LaithToom24/OpAmp/bare_jrnl_new_sample4.pdf

JOURNAL OF OPERATIONAL AMPLIFIER, VOL. 1, NO. 1, DECEMBER 2024 | 1

# The Design and Usage of

# a Operational Amplifier

Laith Toom and Dennis Lee

Abstract—This document details the design of an operational amplifier and using it to design a non-inverting amplifier. The design process of the amplifier will involve a DC analysis for purposes of biasing, an AC analysis for the purposes of gain, and an AC sweep for the purposes of frequency response.

Index Terms—Operational Amplifier, Circuits, Feedback, Frequency Response

I. INTRODUCTION
T
HE Operational Amplifier, otherwise referred to as an Op-Amp, operates on a differential input with an “open-loop” gain of typically at or exceeding 60 dB, input resistance of typically at or exceeding 10 MΩ, and output resistance typically at or exceeding 100 Ω. As such, the current that enters the Op-Amp is typically in the range of µ A. As such, the ideal Op-Amp is considered to have infinite open-loop gain, infinite input resistance, and zero output resistance. Given this description, an Op-Amp may be implemented in many different ways. The Op-Amp considered here will consist of three stages using BJT transistors: the Q2N3904 and the Q2N3906.

A1

V2

V1

A2 | A3 | Vo

Fig. 1. Multi-Stage Amplifier Representation

Fig. 2 shows the implementation of the Op-Amp without frequency compensation.
Ideally, the open-loop gain of the Op-Amp is given by the product of the stage gains, however, each stage will have an input and output resistance. Thus, the product of all of the gains will also be multipled by ratios derived from voltage division.

A = A1A2A3 ·

Zi2
Zo1 + Zi2

·

Zi3
Zo2 + Zi3

·

ZL
Zo3 + ZL
(1)

We can call the product of these ratios the “transmission” of the Op-Amp and denote it as σ, where the transmission of each stage will be denoted as σ1, σ2, and σ3 respectively.

σ = σ1σ2σ3 =

Zi2
Zo1 + Zi2

·

Zi3
Zo2 + Zi3

·

ZL
Zo3 + ZL

(2)

This paper was produced by the IEEE Publication Technology Group. They are in Piscataway, NJ.
Manuscript received April 19, 2021; revised August 16, 2021.

Ideally, we don’t want to lose any output, thus, we want each ratio to be one and this σ to be ideally one. Practically, σ should be close to one if each amplifier stage is designed well. Before the gain of each stage is calculated, we must first consider the biasing of the transistors within the Op-Amp.

II. THE RESISTANCES AND STAGE GAINS OF THE OP-AMP

A. Finding the Resistor Values
1) Current Mirror Load and Finding Resistor R1: The first stage of the Op-Amp, which we will denote S1, will receive the inputs V2 and V1. It will also be supplied directly with a current source; where this current source is constructed using a current mirror.
Q1 | Q2
VCC | VCC

R1

I

VEE | VEE

Load

I

Fig. 3. The Current Mirror Load

With the short from base to collector for Q1, the collector voltage of Q1 is now ideally the base voltage of Q1. Since the bases of Q1 and Q2 are shorted together, the base voltages of Q1 and Q2 are made ideally equivalent. Since the emitters Q1 and Q2 are both wired to VCC, they also have equal emitter voltages. Thus, the base to emitter voltage for Q1 and Q2 are equal. As a result, the current through Q1 will be ideally the same as the current through Q2, and so the current is “mirrored”. With a nodal analysis, we see that I depends on the potential difference across R1, and with the short from collector to base, we see that this potential difference is VCC− (VEE + VBE), thus we have an equation for I.

I =

VCC − VEE − VBE
R1

(3)

I will be the current needed to bias the amplifier, and as such, we can derive an equation for R1 as a function of I using equation 3.

0000–0000/00$00.00 © 2021 IEEE

JOURNAL OF OPERATIONAL AMPLIFIER, VOL. 1, NO. 1, DECEMBER 2024 | 2

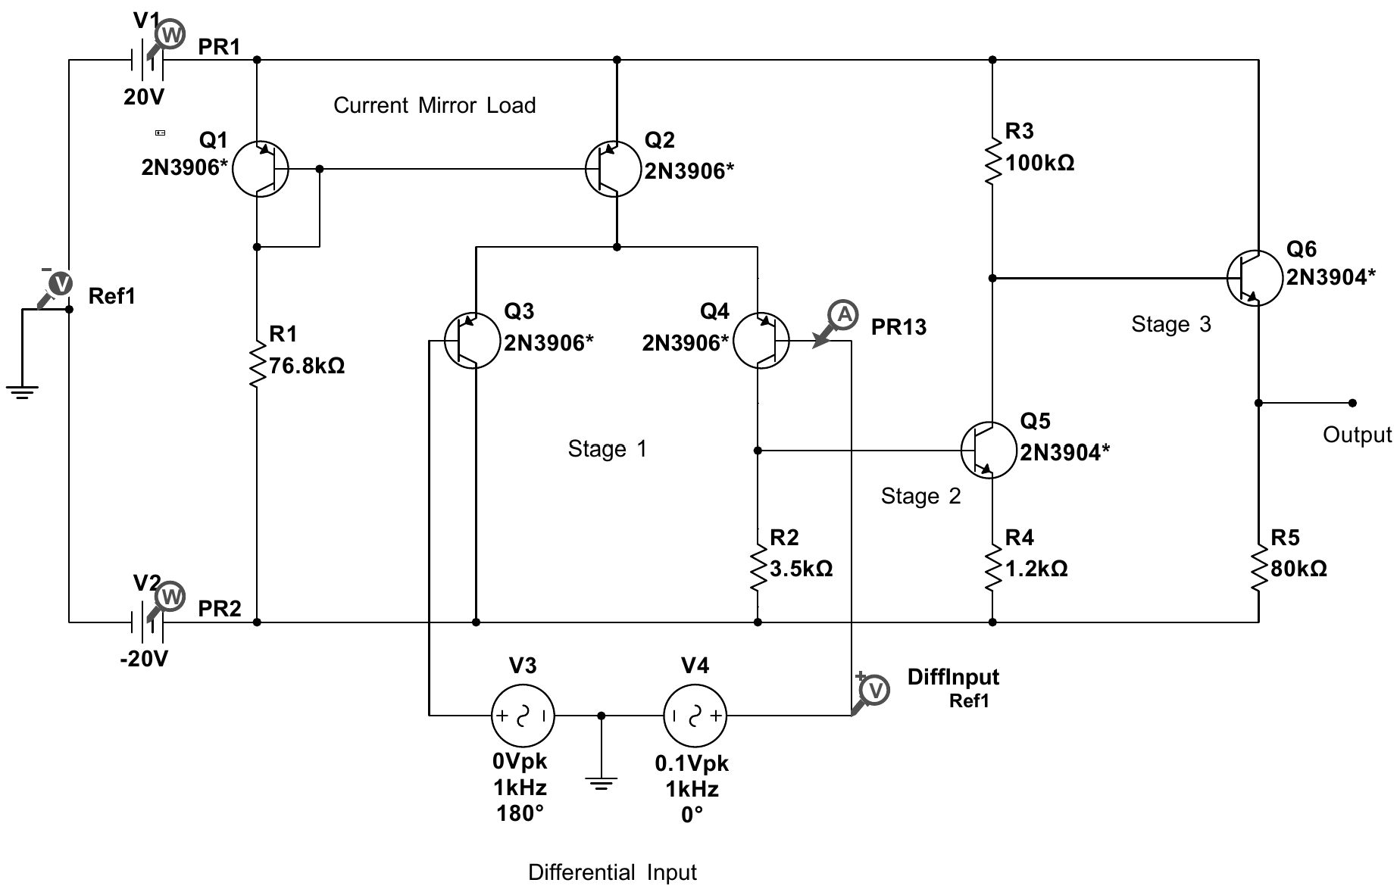
[picture p1: figure]

Fig. 2. Op-Amp Schematic Without Frequency Compensation

R1 =

VCC − VEE − VBE
I

(4)

Thus, R1 will change the biasing of the Op-Amp, but it will not directly affect the gain of the circuit. This will not be the case for the other resistors.
2) The Differential Stage and the First Stage Gain A1: The first stage of the Op-Amp is a differential bipolar amplifier; in which PNP transistors are used and the output is single-sided.
Q3 | Q4

VEE

I
2

R2

VEE

Vo

Load

I
2

VCC

I

V1 | V2

Fig. 4. The Differential Amplifier

Since the output of this differential amplifier is fed into another amplifier (the second stage of the Op-Amp), there will be some finite load at the output. The impedance of this load will then be the input impedance of the second stage, Zi2 .
The small signal equivalent of the differential amplifier can be used to determine the gain A1, but due to the single-sided output, only the half-circuit is needed. However, note that the input is differential, thus the input of the amplifier will be half of the actual input; in which the DC offset goes to AC ground.

ie

R2

vo

Zi2

re4

βib = ic

ic
β v2 =

vi
2

Fig. 5. The Differential Amplifier Small Signal Equivalent

JOURNAL OF OPERATIONAL AMPLIFIER, VOL. 1, NO. 1, DECEMBER 2024 | 3

From the small signal half circuit, nodal analysis suggests

ie = −

v2
re4

=⇒ ie = −

1
2

gm4

vi | (5)

as well as

ic =

vo
R2 ∥ Zi2

(6)

Using the current relationship between ie and ic for a bipolar junction transistor, we also find

ic =

β
β + 1

ie =⇒

vo
R2 ∥ Zi2

= −

β
2 (β + 1) gm4

vi (7)

From equation (7), the gain can be derived as so.

vo
vi

= A1 = −

β
2 (β + 1) gm4

(R2 ∥ Zi2

) | (8)

However, it’s not yet clear what resistor values A1 depends on until an expression for Zi2
is found. This impedance will be derived after all of the stage gains are found.
3) The Common Emitter Amplifier and the Second Stage Gain A2: The second stage of the Op-Amp is a common emitter amplifier; in which a NPN transistor is used.

Q5

R4

VEE

R3

Vcc

Load

Vo

Vi

Fig. 6. The Common Emitter Amplifier

Similar to the first stage, the output of the common emitter amplifier will be fed into the third stage, and the impedance of the load will then be the input impedance of the third stage, Zi3
. The gain can be determined by using the small signal equivalent model.

R4

ie

R3 ∥ Zi3

vi

ic
β
re5

gm5 vbe = ic

vo

Fig. 7. The Common Emitter Amplifier Small Signal Equivalent

From the small signal equivalent model, ie and ie can be expressed using Ohm’s Law.

ic = −

vo
R3 ∥ Zi3

(9)

ie =

vi
re5 + R4

(10)

Thus, the gain A2 can be derived.

vo
vi

= A2 = −

R3 ∥ Zi3
re5 + R4

(11)

As with the first stage gain, Zi3 must be derived before determing which resistors the second stage gain will depend on.
4) The Common Collector Amplifier and the Third Stage Gain A3: The third stage of the Op-Amp is a common collector amplifier; which is also known as a emitter-follower, and is implemented using a NPN transistor.

Q6

R5

VEE

Vcc

Load

Vo

Vi

Fig. 8. The Emitter-Follower

While the output of this amplifier will not be fed into another stage, it will be connected to some load, such as a feedback system. That said, this is simply a buffer amplifier; in which there is no amplification nor, ideally speaking, attenuation. By using the small signal model, this can be proven.

JOURNAL OF OPERATIONAL AMPLIFIER, VOL. 1, NO. 1, DECEMBER 2024 | 4

R5 ∥ ZL

ie

vi

ic
β
re6

gm6 vbe = ic

vo

Fig. 9. The Emitter-Follower Small Signal Equivalent

From the small signal model, vo can be expressed using voltage division, in which re6

and R5 ∥ ZL form the voltage divider.
vo =

R5 ∥ ZL
re6 + R5 ∥ ZL
vi | (12)

Thus, the gain of the third stage can be derived. vo
vi

= A3 =

R5 ∥ ZL
re6 + R5 ∥ ZL

(13)

Note that for ZL = ∞, the equation is simplified. vo
vi

= A3 =

R5
re6 + R5

(14)

Practically, re6

is usually magnitudes smaller than R5 ∥ ZL; in which both ZL and R5 are usually magnitudes above re6 .
Thus, there are two limit conditions we can consider for A3 to verify that the third stage is indeed a buffer amp.

lim re6→0

R5 ∥ ZL
re6 + R5 ∥ ZL

=

R5 ∥ ZL
R5 ∥ ZL
= 1 | (15)

lim
R5∥ZL→∞

R5 ∥ ZL
re6 + R5 ∥ ZL

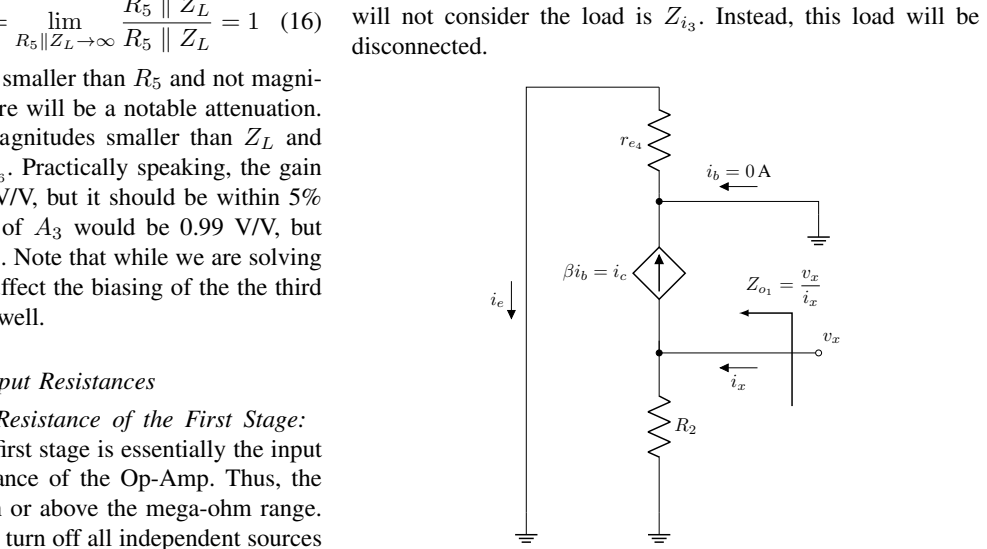
[picture p2: figure]
. Practically speaking, the gain; will not consider the load is Zi3; . Instead, this load will be; disconnected.; βib = ic

= lim
R5∥ZL→∞

R5 ∥ ZL
R5 ∥ ZL

However, if ZL is magnitudes smaller than R5 and not magnitudes larger than re6
, then there will be a notable attenuation. The same applies if R5 is magnitudes smaller than ZL and not magnitudes larger than re6
of this stage will never be 1 V/V, but it should be within 5% of 1 V/V. A fair assumption of A3 would be 0.99 V/V, but this all depends on R5 and ZL. Note that while we are solving for stage gains here, R5 will affect the biasing of the the third stage, so it will affect re6
as well.
B. Finding the Input and Output Resistances
1) The Input and Output Resistance of the First Stage: This resistance, seeing as the first stage is essentially the input stage, is also the input resistance of the Op-Amp. Thus, the resistance is expected to be in or above the mega-ohm range. In order to find this resistance, turn off all independent sources and apply a test source where the resistance is met. For the first stage, recall Fig. 5 and replace the differential input with test source vx.

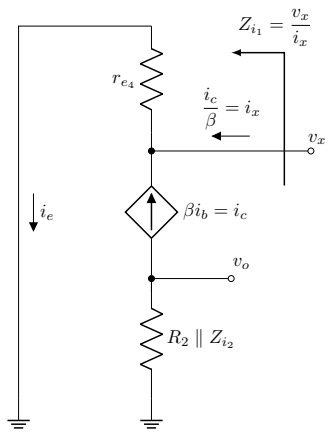
[picture p3: figure]
βib = ic

Fig. 10. Testing the Differential Amplifier for Input Resistance

Either by reflecting the emitter resistance re4
to the base
or by using nodal analysis with the current relation between ie and ib, the input resistance is easily derived. We will use nodal analysis to find Zi1

ie =

vx
re4

(17)

ix = ib | (18)
ie = (1 + β)ib | (19)

=⇒

vx
re4
= (1 + β)ix | (20)

=⇒

vx
ix

= Zi1 = (1 + β)re4
(21)

Starting with the same small signal model, we can ground the input terminal and place a test source at the output terminal to find the output impedance of the first stage, Zo1 .
However, since we are inputting a source at the output, we

Fig. 11. Testing the Differential Amplifier for Output Resistance

Since the input is grounded, this means there is no voltage applied at the base of the transistor. Thus, there is no current

JOURNAL OF OPERATIONAL AMPLIFIER, VOL. 1, NO. 1, DECEMBER 2024 | 5

flowing into the terminal, making ie = ic = 0 A as they
directly depend on ib. As such, the dependent current source
supplies no current, and so the current ix is not split.

ix =

vx
R2

(22)

=⇒

vx
ix
= Zo1 = R2 | (23)
2) The Input and Output Resistance of the Second Stage: The same process applied to the first stage is used here, however, now recall Fig. 7 as the circuit to analyze.

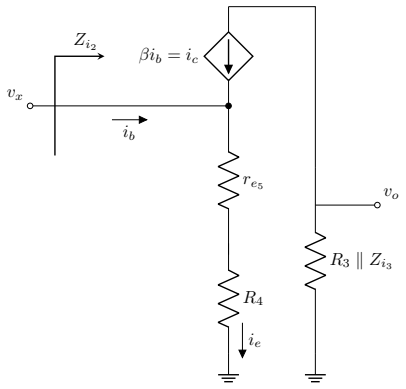
[picture p4: figure]
βib = ic

Fig. 12. Testing the Common Emitter Amplifier for Input Resistance

Using nodal analysis, finding the input impedance is a simple process.

ib = ix | (24)
ie = (1 + β)ib | (25)

ie =

vx re5 + R4 | (26)

=⇒ (1 + β)ix =

vx re5 + R4 | (27)

=⇒

vx
ix
= Zi2 = (β + 1)(re5 + R4) | (28)

Looking at Fig. 12, if the input terminal is grounded and vx is placed at the output terminal, it’s clear to see that the output resistance is simply R3.

Zo2 = R3 | (29)
3) The Input and Output Resistance of the Third Stage: Recall the small signal model of the third stage (Fig. 9). The same process used for the previous two stages can be used here.

R5 ∥ ZL

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
Fig. 13. Testing the Emitter-Follower for Input and Output Impedance

From this circuit, the input and output impedances are easy to see. For the input resistance, re6

and R5 ∥ ZL are in series, thus they can be reflected to the base as a sum.

Zi3 = (β + 1)(re6 + R5 ∥ ZL) | (30)

For the output resistance, re6

and R5 are in parallel.

Zo3 = re6

∥ R5 | (31)
C. The Resistor Dependent Gain Equation
With all of the resistances and gains found, it’s now possible to write an equation for A.

A1 = −

β(R2 ∥ (β + 1)(re5 + R4)) 2(β + 1)re4 | (32)

A2 = −

R3 ∥ (β + 1)(re6 + R5 ∥ ZL) re5 + R4 | (33)

σ1 =

(β + 1)(re5 + R4) R2 + (β + 1)(re5 + R4) | (34)

σ2 =

(β + 1)(re6 + R5 ∥ ZL) R3 + (β + 1)(re6 + R5 ∥ ZL) | (35)

σ3 =

ZL (re6 ∥ R5) + ZL | (36)

A = A1A2A3 · σ1σ2σ3 = A

′
- σ | (37)

See Eq. (38) for the full equation for A′ and Eq. 39 for the
full equation of σ. Since σ ≈ 1, A′
is the primary concern
for determing A. Since A depends on the value of the emitter resistances, recall that the emitter resistances depend on the collector current flowing through the transistors, and those currents depend on the resistor values chosen for the Op-Amp. Thus, the resistor values must be chosen with consideration for gain A and proper biasing.

III. THE DC BIASING
OF THE OP-AMP
Recall that the emitter resistance of a BJT is given by the ratio of the thermal voltage VT to the collector current Ic.

re =

VT Ic | (40)

Looking back to the current mirror (Fig. 3) and Eq. (4), this is where the main part of the biasing comes into play. With the

JOURNAL OF OPERATIONAL AMPLIFIER, VOL. 1, NO. 1, DECEMBER 2024 | 6

A

′ =

β(R2 ∥ (β + 1)(re5 + R4))
2(β + 1)re4

·

R3 ∥ (β + 1)(re6 + R5 ∥ ZL) re5 + R4

·

R5
re6 + R5

(38)

σ =

(β + 1)(re5 + R4)
R2 + (β + 1)(re5 + R4)

·

(β + 1)(re6 + R5 ∥ ZL)
R3 + (β + 1)(re6 + R5 ∥ ZL)

·

ZL
(re6

∥ R5) + ZL

(39)

equation, I can be anything. As such, we can already control re4
in regards to current.

Ic4 =

β
β + 1

Ie4
(41)

Ie4 =

I
2

(42)

re4 =

VT
Ic4

=

2 (β + 1) VT
βI | (43)

In regards to re5

, the base current of Q5 will be given by current division.

Ib5 =

R2
R2 + Zi2

Ic4
(44)

=⇒ Ib5 =

R2
R2 + Zi2
β

β + 1
I
2

(45)

=⇒ Ic5 =

R2
R2 + Zi2
β

2
β + 1
I
2

(46)

Ic5 =

VT
re5

(47)

=⇒

(β + 1)re5 + (β + 1)R4 + R2 re5

=

R2
VT
β

2
2(β + 1)
I (48)

=⇒ re5 =

R2 + (β + 1)R4
β

2
IR2
2(β + 1)VT

− (β + 1)

(49)

Then for re6

, the base current of Q6 will be given by another current division; in which the collector current of Q5 will be divided between R3 and Zi3

Ib6 =

R3
R3 + Zi3

Ic5
(50)

=⇒ Ib6 =

R3
R3 + Zi3

·

R2
R2 + Zi2
β

2
β + 1
I
2

(51)

=⇒ Ic6 =

R3
R3 + Zi3

·

R2
R2 + Zi2
β

3
β + 1
I
2

(52)

Ic6 =

VT
re6

(53)

=⇒ re6 =

R3 + (β + 1)(R5 ∥ ZL)
β

3
IR3
2(β + 1)VT
R2
R2 + Zi2
− (β + 1)

(54)

However, despite deriving these equations, tweaking the resistor values based off of these equations will not always match the measured gain. This is because the equations always assume the transistors are always operating in active mode, and if a change in a resistor value pushes a transistor into saturation, these equations are no longer applicable.

IV. EXPERIMENTING WITH RESISTOR VALUES
While calculating the resistor values would be both difficult and likely inefficient, the equation derived for the open-loop gain without considering transmission loss, see Eq. (38), provides some incentive on how to tweak the resistor values.
A. Current Mirror Load
For the current mirror, R1 set to 76.8 kΩ was found to properly bias the amplifier; in which the current supplied using this resistance can be calculated using Eq. (3), and when calculated, provides I ≈ 0.512 mA.
B. First Stage
For the first stage, since R2 is in parallel with Zi2
, in-creasing R2 will not increase the gain. Instead, the parallel combination will approach the lesser resistance. So in order to increase the gain of the first stage, setting R2 to 3.5 kΩ and tweaking R4 would be a decent method.
C. Second Stage
Note that the second stage gain is inversely proportional to R4, so while setting R4 to a very high value would seem like a good idea as to increase the first stage gain, we instead want to limit R4. Since R4 is scaled by β+1 for the previous stage, this means R4 will already be far larger from the perspective of the first stage than for the second stage. In this case, setting R4 to 1.2 kΩ provides satisfactory results.
As for R3, we have the same situation as with the first stage. Thus, we should pick a value for R3 and then tweak R5. As such, setting R3 to 100 kΩ provides good results.
D. Third Stage
With the third stage, setting R5 to a very large value, such as in the megaohms, would work unlike the first stage since, as Eq. (13) suggests, R5 ≫ re6 provides gain close to 0 dB, which is ideal. However, this is only the case when the Op-Amp is not supplying a finite load. When a finite load ZL is attached to the output terminal of the Op-Amp, R5 will be parallel to this impedance, and as shown in Eq. (13), this effects the gain of the buffer stage. The effect can be shown by limits in which ZL is kept constant while R5 is taken to infinity.

lim
R5→∞

R5 ∥ ZL
re6 + R5 ∥ ZL

=

ZL
re6 + ZL

(55)

With this simplification, it is clear to see that R5 is eventually disregarded as it is increased. This behavior is non-ideal because this means that the gain now depends largely on

JOURNAL OF OPERATIONAL AMPLIFIER, VOL. 1, NO. 1, DECEMBER 2024 | 7

ZL. Specifically, the measure of how large ZL is to re6
. For
example, if R5 was chosen to be 1000re6
, then the buffer gain
without a load would be 1000
1001 V/V (see Eq. (14)). However, if we connect a load of ZL = 100re6
, then firstly, the parallel combination can be computed. From there, we can compute the gain.

ZL ∥ R5 = 100re6

∥ 1000re6
(56)

=

100re6

- 1000re6
100re6 + 1000re6

(57)

=

10⁵
1100
- re6
(58)

=⇒ A3 =

10⁵
1100 re6
re6 +

10⁵
1100 re6

(59)

=

10⁵

1100

10⁵+1100

1100 | | (60)

=

10⁵
10⁵ + 1100

=

1000
1011
V/V | (61)

=⇒ ∆A3 =

1000
1001

−

1000
1011
≈ 10⁻² V/V | (62)
≈ 0.0863 dB | (63)

While R5 and ZL only differed by a factor of ten, it’s clear to see that this loss in gain can be increased if this factor increases, and that would be very likely if R5 is in the range of megaohms. Thus, R5 was chosen to be 80 kΩ.

V. OP-AMP SPECIFICATIONS WITH REGARDS TO RESISTOR VALUES
A. Power Dissipation

With the resistor values chosen, the power dissipated by the Op-Amp is easily calculated. For currents that flow to VEE, the sum of those currents multiplied by VEE provides the power dissipated as a result of those currents.

PEE = |VEE|

X

N

i=1

Ii | (64)

Then for currents flowing to VCC, replace VEE with VCC.

PCC = VCCX

M

i=1

Ii | (65)

Thus, the total power dissipation is given by the following equation.

Pnet = VCCX

M

i=1

Ii + |VEE|

X

N

i=1

Ii | (66)

With this equation, the total power dissipation was found to be 58 mW. The simulation reported a total power dissipation of 58.4 mW.

B. Input Bias Current
Due to the nature of BJTs, there is some current introduced by the input terminal into our Op-Amp design. As such, this current is called the input current or input bias current. This current was found to be approximately 1 microamp.
C. Measured Open-Loop Gain
When performing an AC Sweep, the open-loop gain was found to be 61.84 dB. When applying equations (2), (38), (43), (49), and (54); the open-loop gain was calculated to be 62.6109 dB. Thus, the difference relative to the calculation was approximately 1.2%.

E% = Acalculated − Ameasured

Acalculated

≈ 1.23% | (67)

The value of σ was about 0.987.

D. Open-Loop Bandwidth and Dominant Pole
Bode plots for the open-loop gain and phase were created in Matlab. See Fig. 14 for open-loop gain and 15 for open-loop phase. The plots suggests that a pole exists at 258.73 kHz, thus a bandwidth of 0 Hz to 258.73 kHz.
E. Common-Mode Input Range
For the common-mode input range, the circuit analysis is only concerned with the first stage of the Op-Amp since it acts as the input stage. As such, referring back to Fig. 4, VCMmin and

VCMmax
can be calculated by assuming the saturation conditions VCB = 0.4 V, VCE = 0.3 V, and VEB = 0.7 V.
VCMmin = IcR2 + VCB − VCC | (68)

≈

I
2
R2 + VCE − VCC = −18.7045 V | (69)
VCMmax = VCC − VCE − VEB = 19 V | (70)

VI. DC TRANSFER CHARACTERISTICS
Now with the Op-Amp designed, we can now perform various tests on the Op-Amp. For the DC transfer characteristics of the Op-Amp, we will consider that the inverting terminal is grounded, the non-inverting terminal is connected to a DC supply, and there is a 10 kΩ load.

−

+

A

Vi

RL = 10 kΩ

We will sweep Vi from -100 mV to 100 mV in steps of 0.1 mV, and the slope of the linear aspect of the DC Transfer characteristics will yield the gain. This gain be compared to the calculation of A′σ. The data collected from the DC sweep was processed in Matlab (see Fig. 16).

JOURNAL OF OPERATIONAL AMPLIFIER, VOL. 1, NO. 1, DECEMBER 2024 | 8

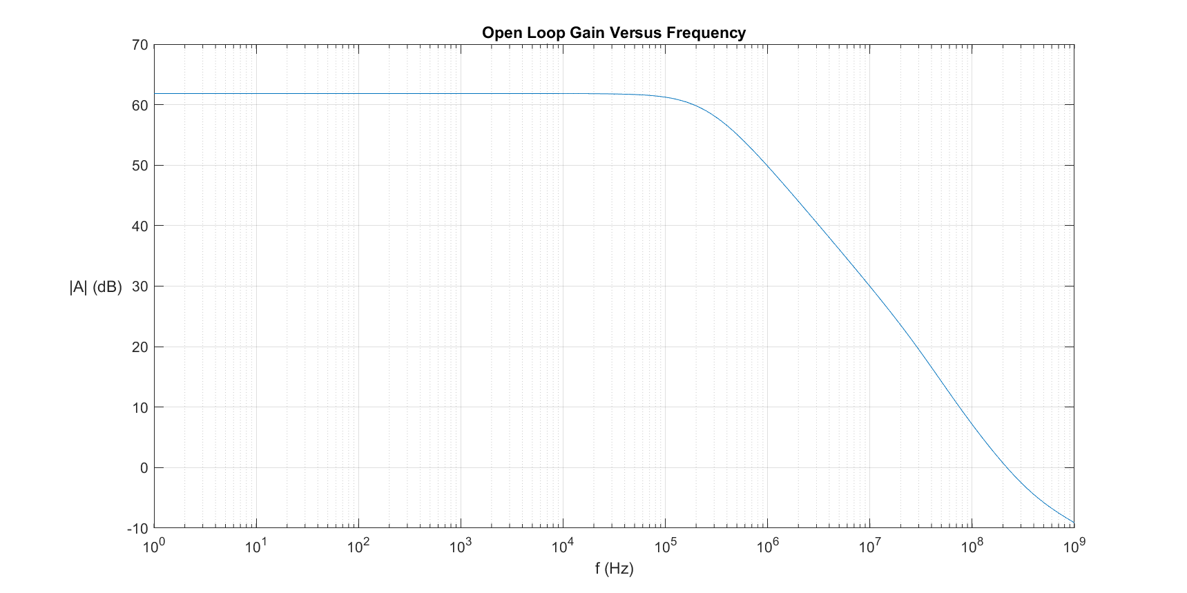
[picture p5: figure]

Fig. 14. Bode Plot of Open-Loop Gain

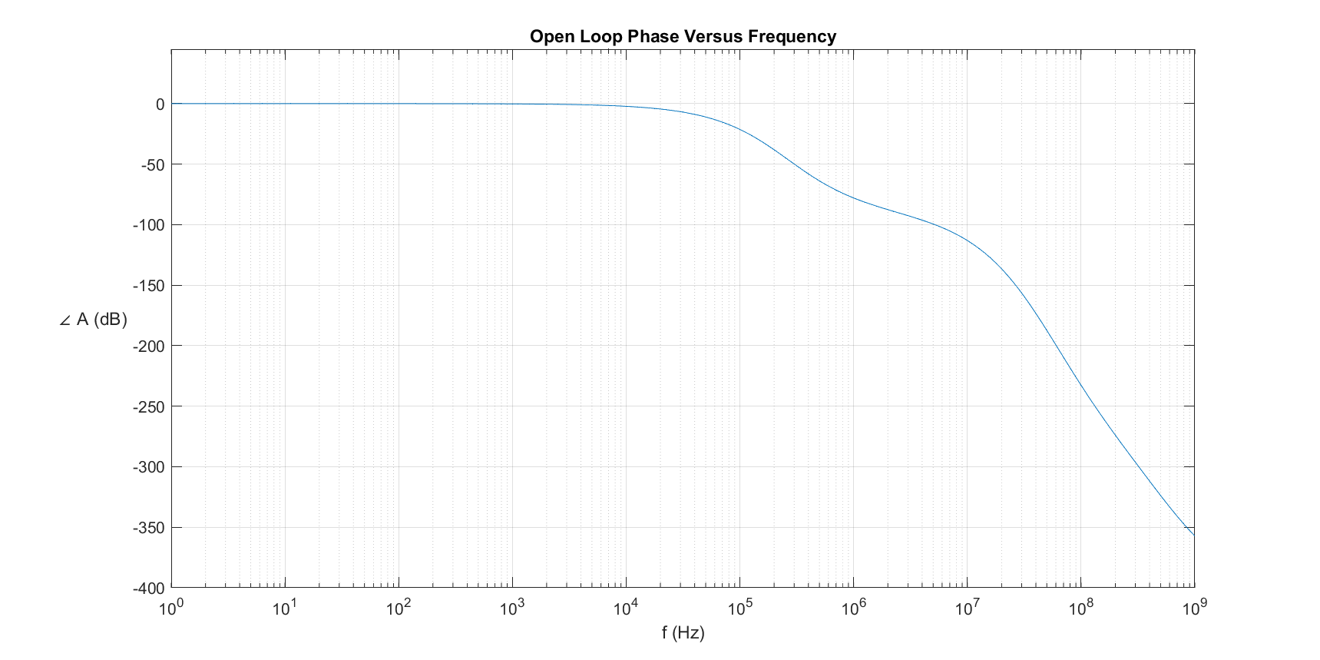
[picture p6: figure]

Fig. 15. Bode Plot of Open-Loop Phase

From the plot, the closest eyeball approximation to linear behavior between Vi and Vo is between 1 mV and 6 mV, in which the slope was calculated to be 1105.5 V/V, or in units of decibels, 60.871 dB. With the formula derived for the open-loop gain, the calculation provided 62.02 dB, thus presenting an error of approximately 2% relative to the calculation.

E% = Acalculated − Ameasured

Acalculated

≈ 1.94% | (71)

Compared to the gain with no attached load, which is equivalent to saying ZL = ∞, there is an approximate loss of 0.969 dB, and this makes sense as ZL = 10 kΩ while R5 = 80 kΩ.

VII. FREQUENCY COMPENSATION
Reviewing the bode plots (see Fig. 14 and Fig. 15), we see that at 0 dB, the phase shift is past -180◦
. As such, the
system is unstable, or rather, if we were to introduce feedback, the system would undergo positive feedback. In order to implement the various Op-Amp circuits we are familiar with,

JOURNAL OF OPERATIONAL AMPLIFIER, VOL. 1, NO. 1, DECEMBER 2024 | 9

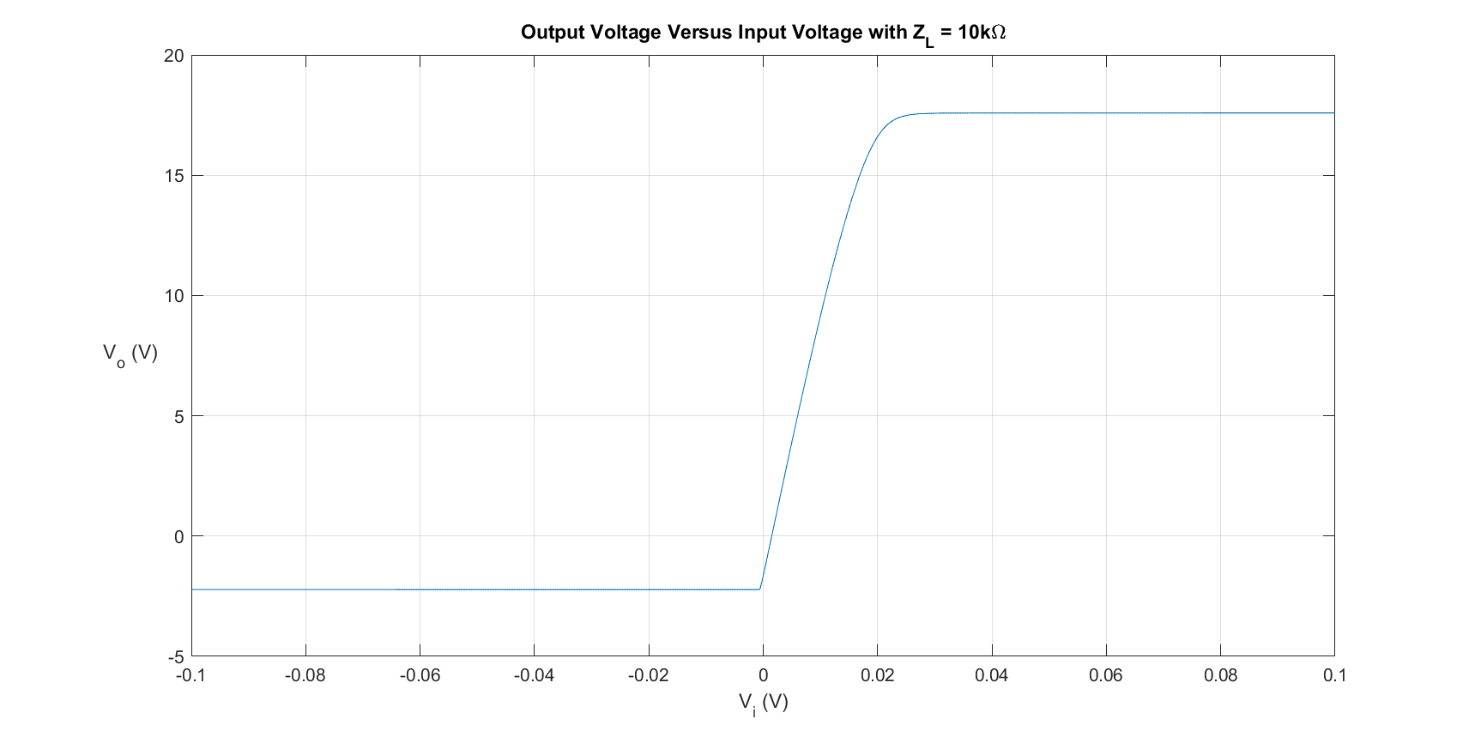
[picture p7: figure]

Fig. 16. DC Transfer Characteristics

such as a non-inverting amplifier or a weighted summer, we need to alter the design such that the phase shift is within -180◦ to 180◦ when the gain is 0 dB. While there are a few different methods of so-called frequency compensation, we will apply “Miller’s compensation”.

A. Miller’s Compensation Capacitor

After experimenting with different feedback capacitor place-ments, the best placement was found to be a 200 pF capacitor at the third stage.

Q6

R5

VEE

Vcc

Load

Vo

Vi

Cm = 200 pF

Fig. 17. The Frequency Compensated Emitter-Follower

Essentially, the capacitor will provide a pole, and due to Miller’s effect, the compensation capacitor will be amplified. Thus, a smaller capacitor can be used, such as the chosen 200 pF capacitor. However, this new pole becomes the new dominant pole, resulting in a loss of bandwidth. However, at unity gain (0 dB), we now have a phase of approximately −130◦
, thus we are now stable and have a phase margin of approximately 50◦

, which is greater than 45◦ . See Fig. 18 and
19 for this drawback.

VIII. IMPLEMENTING FEEDBACK AND BUILDING A NON-INVERTING AMPLIFIER

With the frequency-compensated Op-Amp, we can now introduce feedback.

−

Op-Amp

Resistor
Network
Vi | Vo

Fig. 20. Block Diagram for a Negative Feedback System

For a non-inverting amplifier, we expect the system to amplify the signal, but not invert it. Thus, for any input Vi ,
we expect the output to be |Af | Vi
, where Af is the gain of
the feedback system. As Fig. 20 suggests, the feedback gain Af is given by the following equation.

Af =

A
1 + A(s) · B

=

1

1
A(s) + B

(72)

JOURNAL OF OPERATIONAL AMPLIFIER, VOL. 1, NO. 1, DECEMBER 2024 | 10

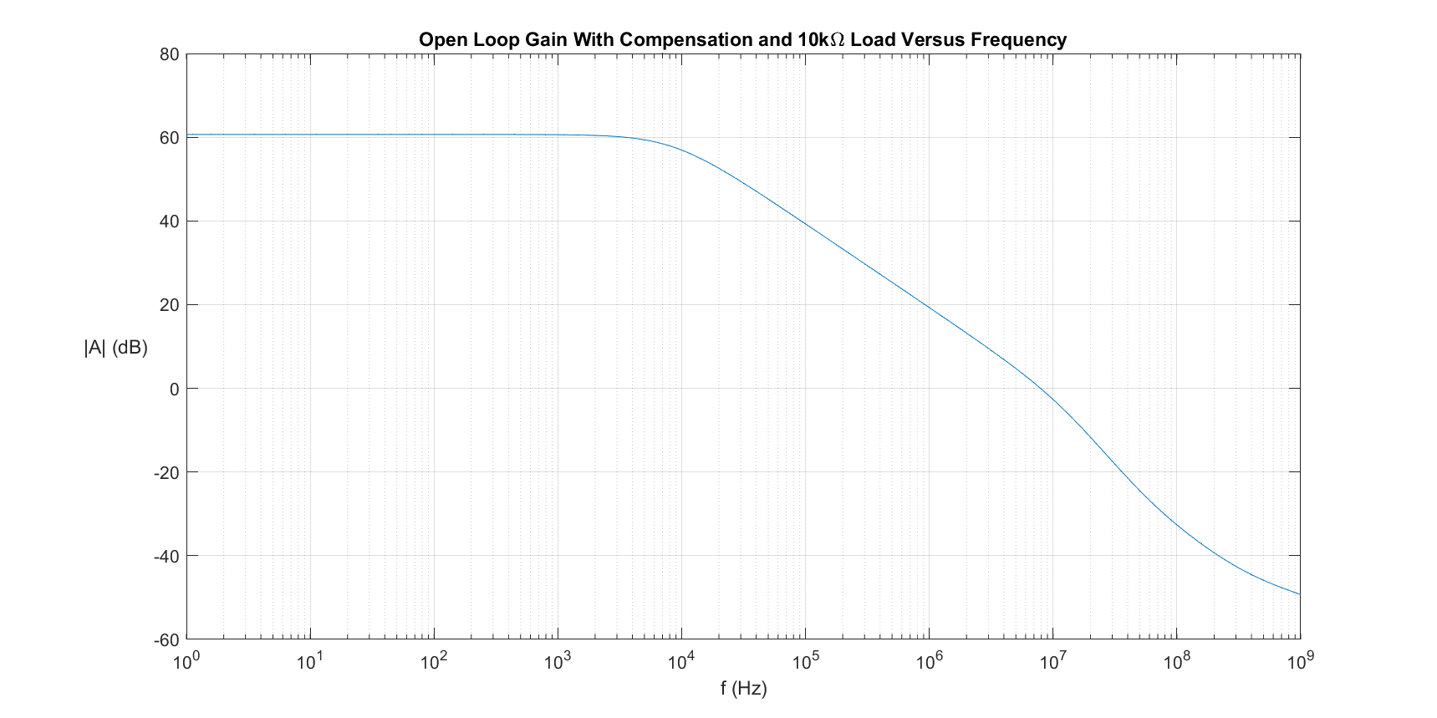
[picture p8: figure]

Fig. 18. Bode Plot of Open-Loop Gain After Frequency Compensation

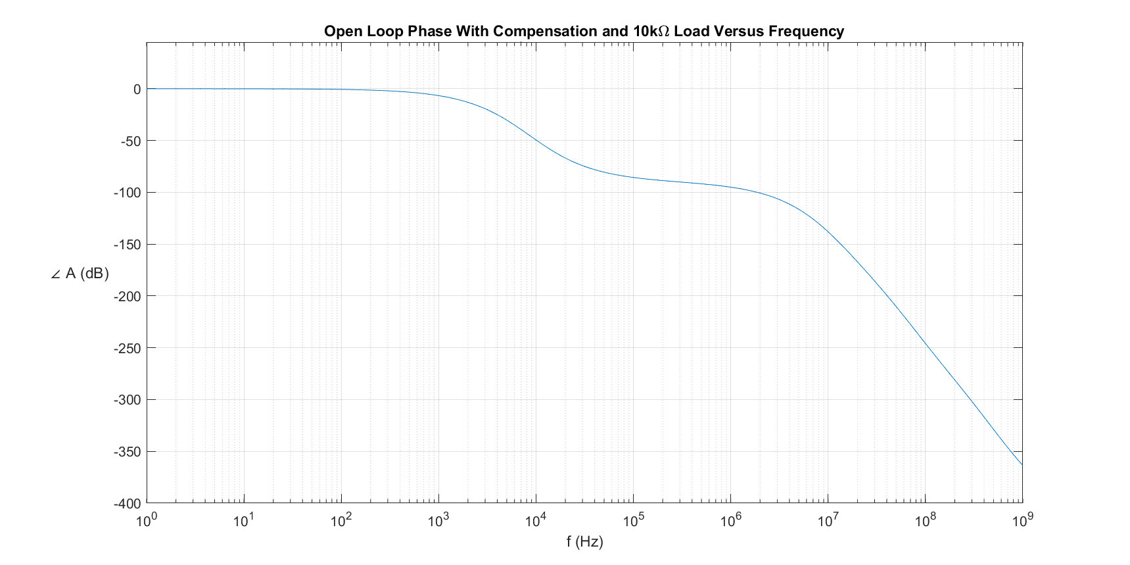
[picture p9: figure]

Fig. 19. Bode Plot of Open-Loop Phase After Frequency Compensation

Where A(s) is the open-loop gain of the Op-Amp and B is the gain from feedback: the “loop gain”. We have already designed A(s), and for a desired Af , we can solve for B.

B =

1
Af

−

1
A(s)

=

A(s) − Af
AfA(s)

(73)

While this suggests that B will or should be frequency-dependent, we can assume that A(s) is constant if s is in the bandwidth found earlier. Thus, B can be implemented as a non-frequency dependent system when we consider this bandwidth.
B =

1
Af

−

1
A

=

A − Af
AfA

(74)

A. Designing the Non-Inverting Amplifier
The goal is to design a non-inverting amplifier with Af = 20 dB= 10 V/V. Recall that A is already experimentally found

JOURNAL OF OPERATIONAL AMPLIFIER, VOL. 1, NO. 1, DECEMBER 2024 | 11

to be approximately 61.84 dB= 1235.95 V/V. As such, B can
be calculated.
Af = 10 | (75)
A ≈ 1235.95 | (76)

=⇒ B ≈

1
10

+

1
1235.95

≈ 0.10081 V/V (77)

This is the gain we expect from our resistor-network. Since the gain is less than one, we can consider using a Voltage-Divider network.

Rb

V

′
o = B · V

′
i
Ra | V
′
| i

Fig. 21. Voltage-Divider Network

As the analysis suggests, B will simply be the ratio of Rb to the sum of Ra and Rb.

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
Ra + Rb

(78)

When we implement this as feedback into your system, V

′
i =
Vo and V

′
o = B ∗ Vo. When we introduce the open-loop gain as our Op-Amp, we can use the idea that the Op-Amp sees a differential input; in which the input is the potential difference from the non-inverting terminal to the inverting terminal. As such, if we wire the output of our voltage-divider network to the inverting terminal of the Op-Amp, we essentially achieve the same functionality as the adder seen in Fig. 20; in which the adder acts as a subtracter.

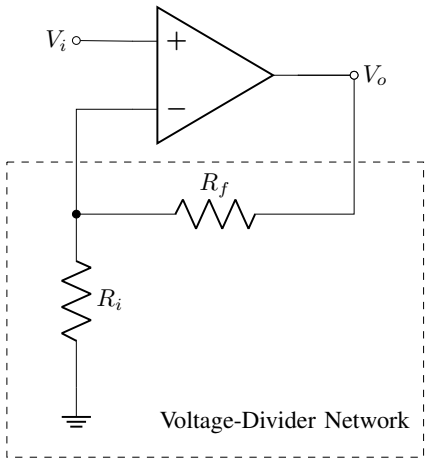
[picture p10: figure]
Voltage-Divider Network

Fig. 22. Non-Inverting Amplifier

For the amplifier, we will let Ra = Rf and Ri = Rb. Seeing as we already calculated B, we can now select values for Ra and Rb. An easy way to do this is to solve for one resistor in terms of the other given that our network is relatively simple.

Eq. (78) =⇒ BRa + BRb = Rb | (79)

=⇒ Rb =

B
1 − B
Ra | (80)

We can now select Ra and then simply calculate Rb. Alternatively, we can select Rb and then calculate Ra.

Ra =

1 − B
B
Rb | (81)

Ideally, we should not lose any of our output. However, with a circuit, the feedback and resistor-network will force some of the output current to flow through the feedback loop, thus reducing the output. In order to remedy this, Rb can be chosen to be some resistance in the kilo-ohm range, thus reducing the amount of current that flows through the feedback loop as per current division. As such, we will choose Ra to be 15 kΩ.

Ra = 15 kΩ =⇒ Rb ≈ 1681.68 Ω | (82)

However, this is not an ideal number to work with, and in practice, is inefficient due to resistor tolerance. Thus we will select 1.65 kΩ for Rb. See Fig. 27 for the schematic of the non-inverting Op-Amp.
1) Input Impedance of the Non-Inverting Amp: With the feedback added, the input impedance of the entire system has changed. Without feedback, the input impedance would just be the input impedance of the first stage Zi1
, but now, the
input impedance is Zi

Zi = Zi1

(1 + AB) ≈ 3.85 MΩ | (83)

To experimentally find the input impedance, we can apply a test source Vx to the terminal and measure the current entering the amplifier. From here, calculate the ratio of the test source voltage to input current, and this ratio should theoretically be the input impedance.

B. Results

With the non-inverting amplifier designed, we can now simulate it and verify that it works to our specifications. An AC Sweep was performed without a load attached to the output of the non-inverting amplifier. With that in mind, the bode plots of the gain and phase with feedback are provided (see Fig. 25 and 26).
When we apply a sinusoidal input vi = 2 sin(ωt) with f = 1 kHz, we observe the following. While we expect an output of approximately vo = 20 sin(ωt), we instead get some kind of distortion (see Fig. 23). This is due to the results of the DC transfer as seen in Fig. 16, in which the linear operating range is only in the millivolts. With the feedback, this range failed to include up to 2 volts as shown in Fig. 24; in which our range of inputs that produce linear outputs is only between approximately -0.4 V and 1.8 V.

JOURNAL OF OPERATIONAL AMPLIFIER, VOL. 1, NO. 1, DECEMBER 2024 | 12

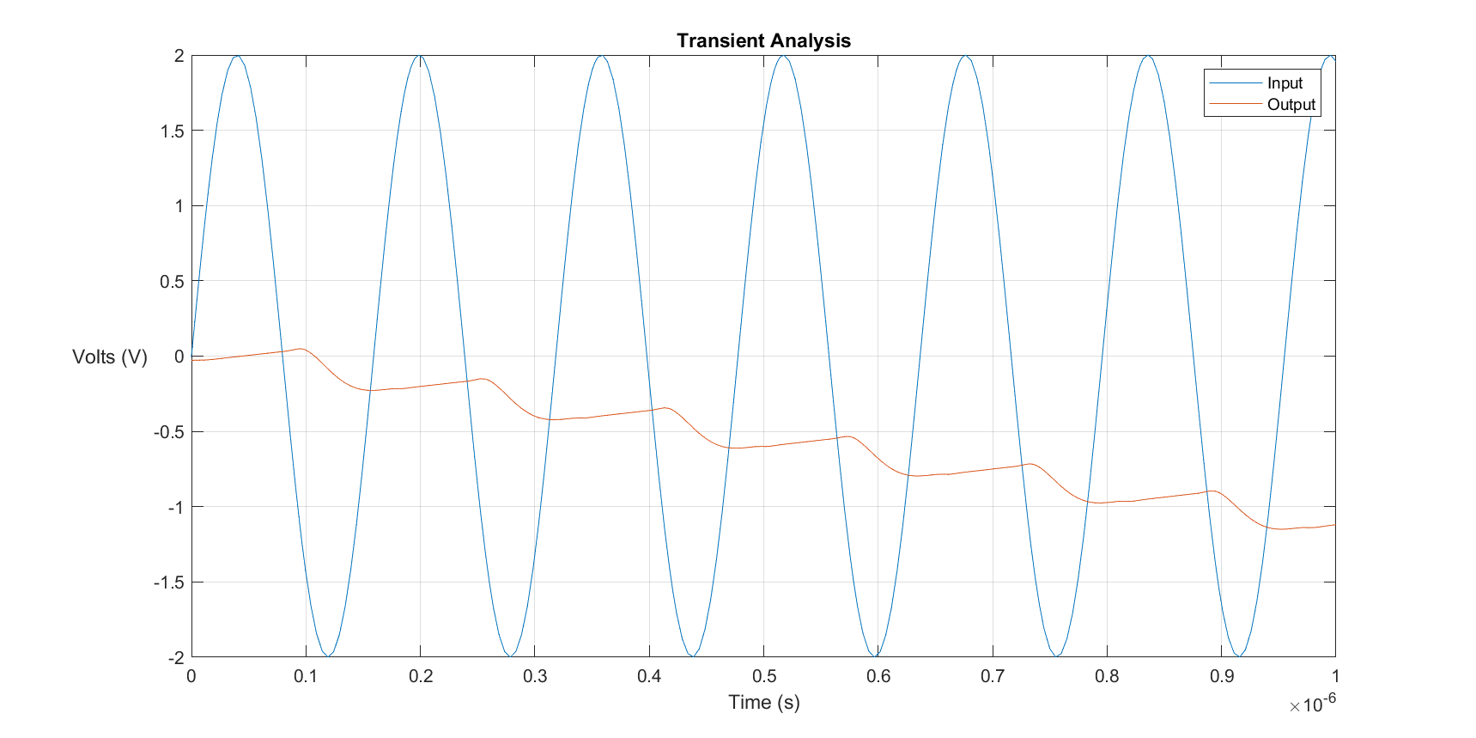
[picture p11: figure]

Fig. 23. Transient Analysis

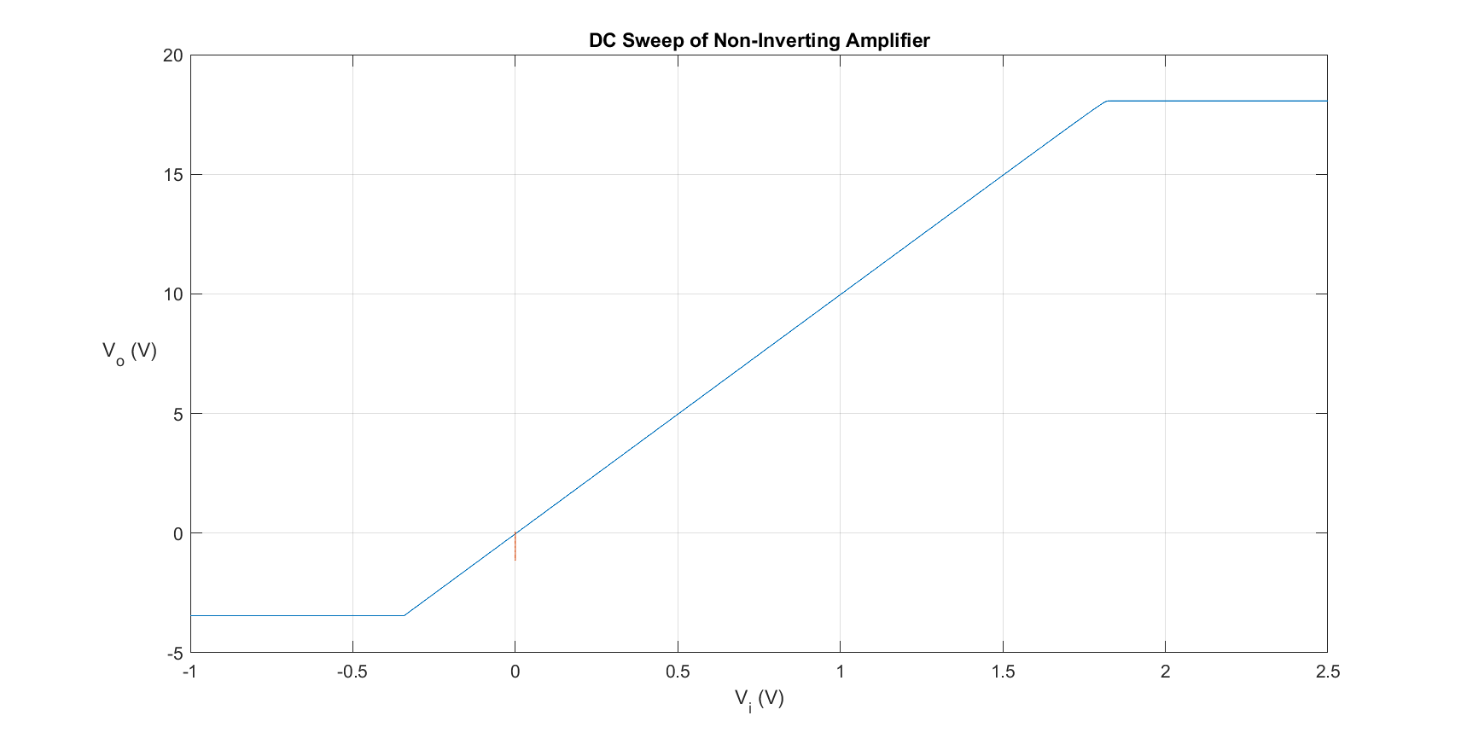
[picture p12: figure]

Fig. 24. DC Sweep for Non-Inverting Amplifier

IX. CONCLUSION

We can summarize the final design with a table of specifications (see Table I) In short, the Op-Amp is itself a complicated and sensitive device. However, when combined with feedback, it can produce powerful results. Furthermore, optimizations to the Op-Amp itself help with these feedback implementations. As a drawback, the gain of the Op-Amp is not used to amplify signals directly, but to ensure that feedback is stable. Alternative designs of this Op-Amp may involve using additional stages to further increase open-loop gain, but that comes at the cost of using more transistors as well as a higher power dissipation. As for the types of transistors used, using MOSFETs instead of BJTs would allow for the Op-Amp to have infinite input impedance and lower power dissipation. Overall, there are many different designs for an Op-Amp; in which the design process of an Op-Amp will involve a theoretical analysis followed by experimental optimizations.

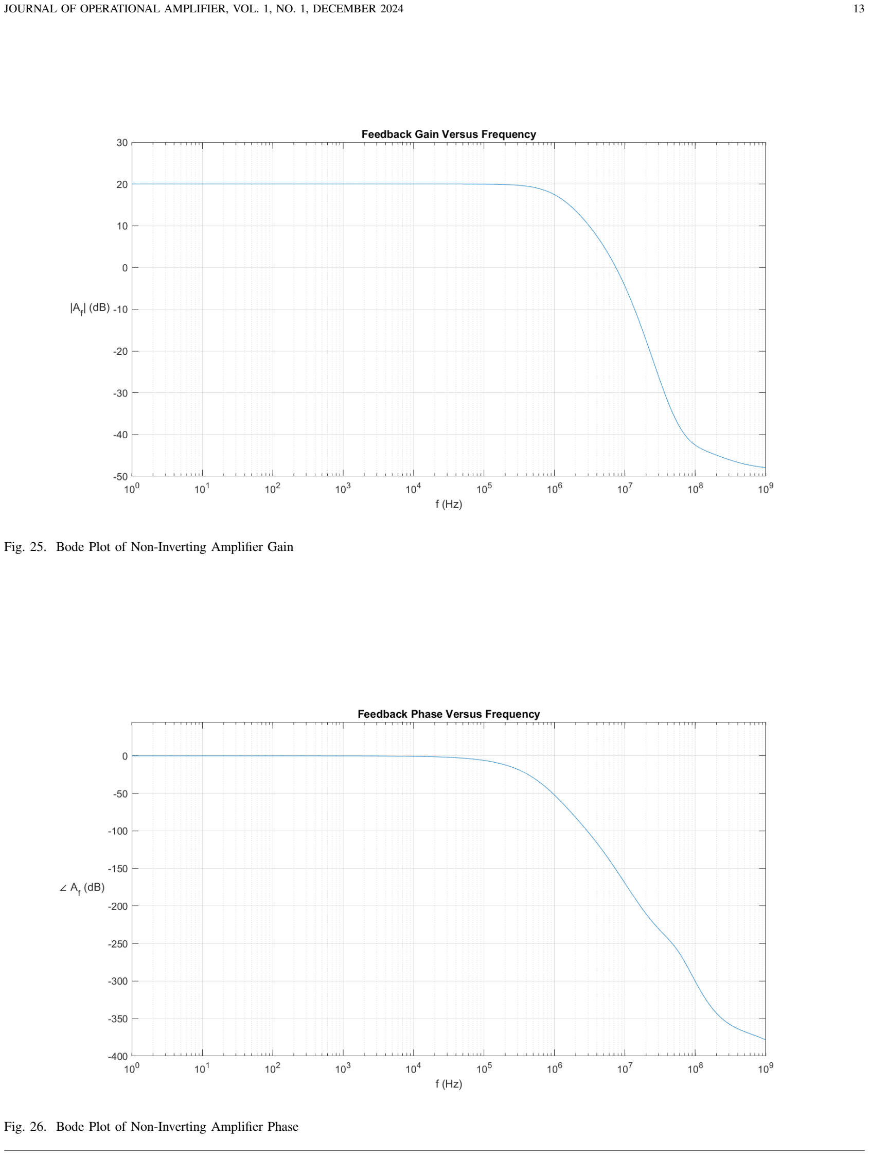
[picture p13: page 13]

JOURNAL OF OPERATIONAL AMPLIFIER, VOL. 1, NO. 1, DECEMBER 2024 | 13

Fig. 25. Bode Plot of Non-Inverting Amplifier Gain

Fig. 26. Bode Plot of Non-Inverting Amplifier Phase

JOURNAL OF OPERATIONAL AMPLIFIER, VOL. 1, NO. 1, DECEMBER 2024 | 14

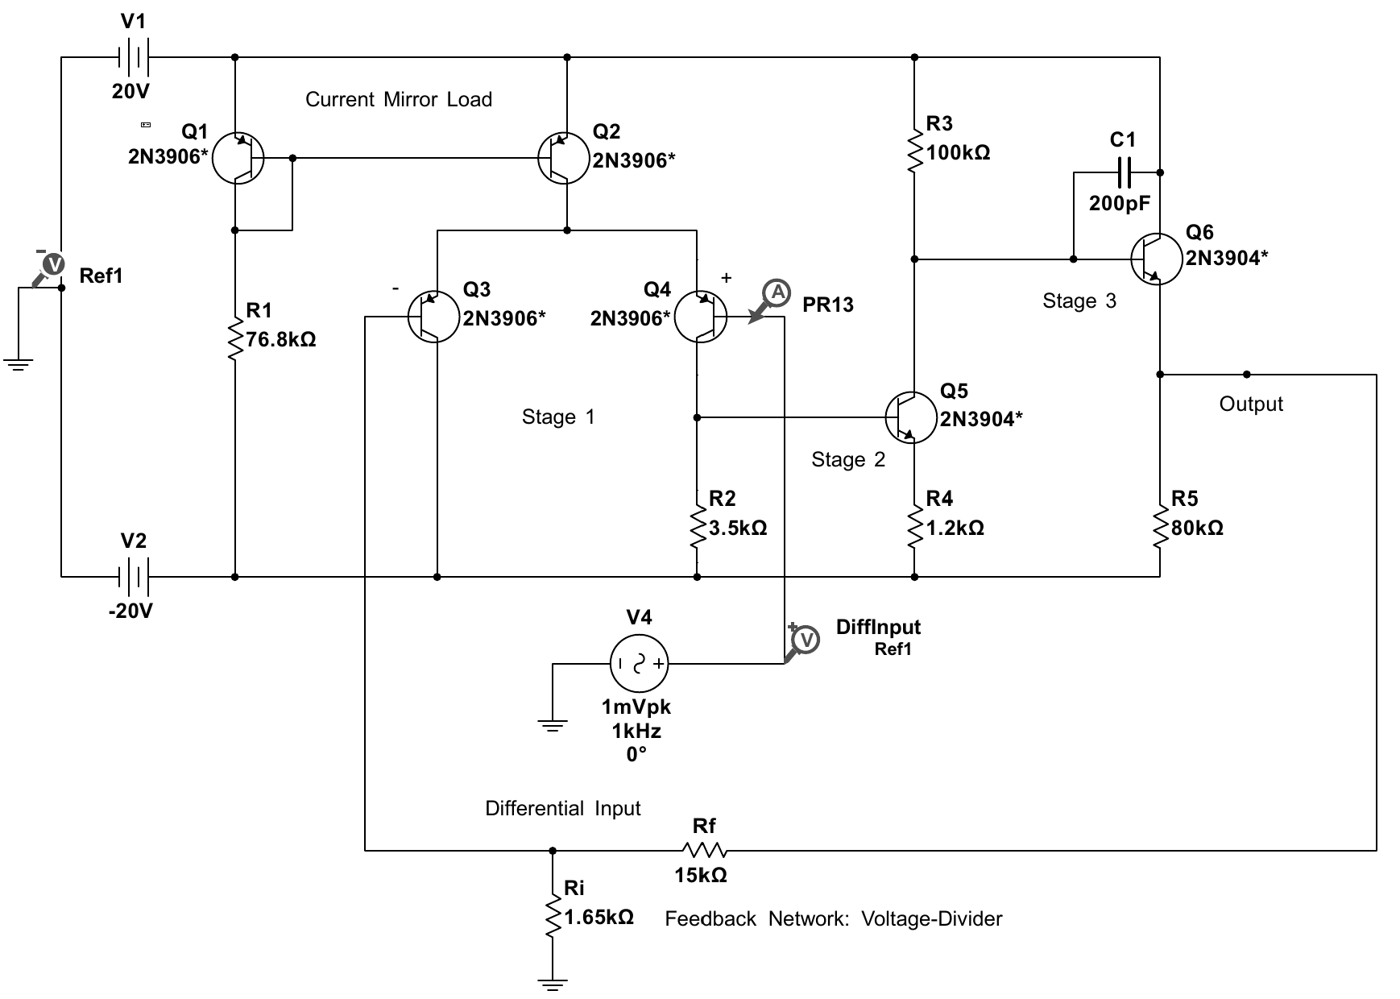
[picture p14: figure]

Fig. 27. Non-Inverting Op-Amp Schematic

TABLE I
OP-AMP SPECIFICATIONS
Parameter | Target | Achieved
Open-Loop Gain A | 60 dB | 61.84 dB
Power Dissipation Pdiss | ≤600 mW | 58.4 mW
Min Common-Mode Input Range VCMmin | N/A | -18.7 V
Max Common-Mode Input Range VCMmax | N/A | 19 V
Input Current Iin | N/A | 0.8 µA
Open-Loop Bandwidth | N/A | 0 Hz to 8.54 kHz
Closed-Loop Phase Margin | ≥ 45◦ | 123.45◦
Closed-Loop Bandwidth | N/A | 0 Hz to 1.115 MHz
Closed-Loop Gain Af | 20 dB | 20.0014 dB
Closed-Loop Unity Gain | 0 dB | 0 dB
Voltage Overshoot | 0 V | -1.93 V
