LaithToom24/OpAmp/(list of files, drawings)

Other design files:
NonInvertingAmplifier.ms14
Operational_Amplifier.ms14
Operational_Amplifier_FrequencyCompensated.ms14
